homusman/EEEbike/(list of files, drawings)

Other design files:
Hardware/KICAD PCB/esp32_ESC/esc_noninterlocked_integrated/freerouting.dsn
Hardware/KICAD PCB/esp32_ESC/esc_noninterlocked_integrated/temp-freerouting.dsn
