homusman/EEEbike/Hardware/KICAD PCB/esp32_ESC/esc_noninterlocked_integrated/esc_noninterlocked_integrated.kicad_pcb

## KiCad design Hardware/KICAD PCB/esp32_ESC/esc_noninterlocked_integrated/esc_noninterlocked_integrated.kicad_pcb (2023-04-12)

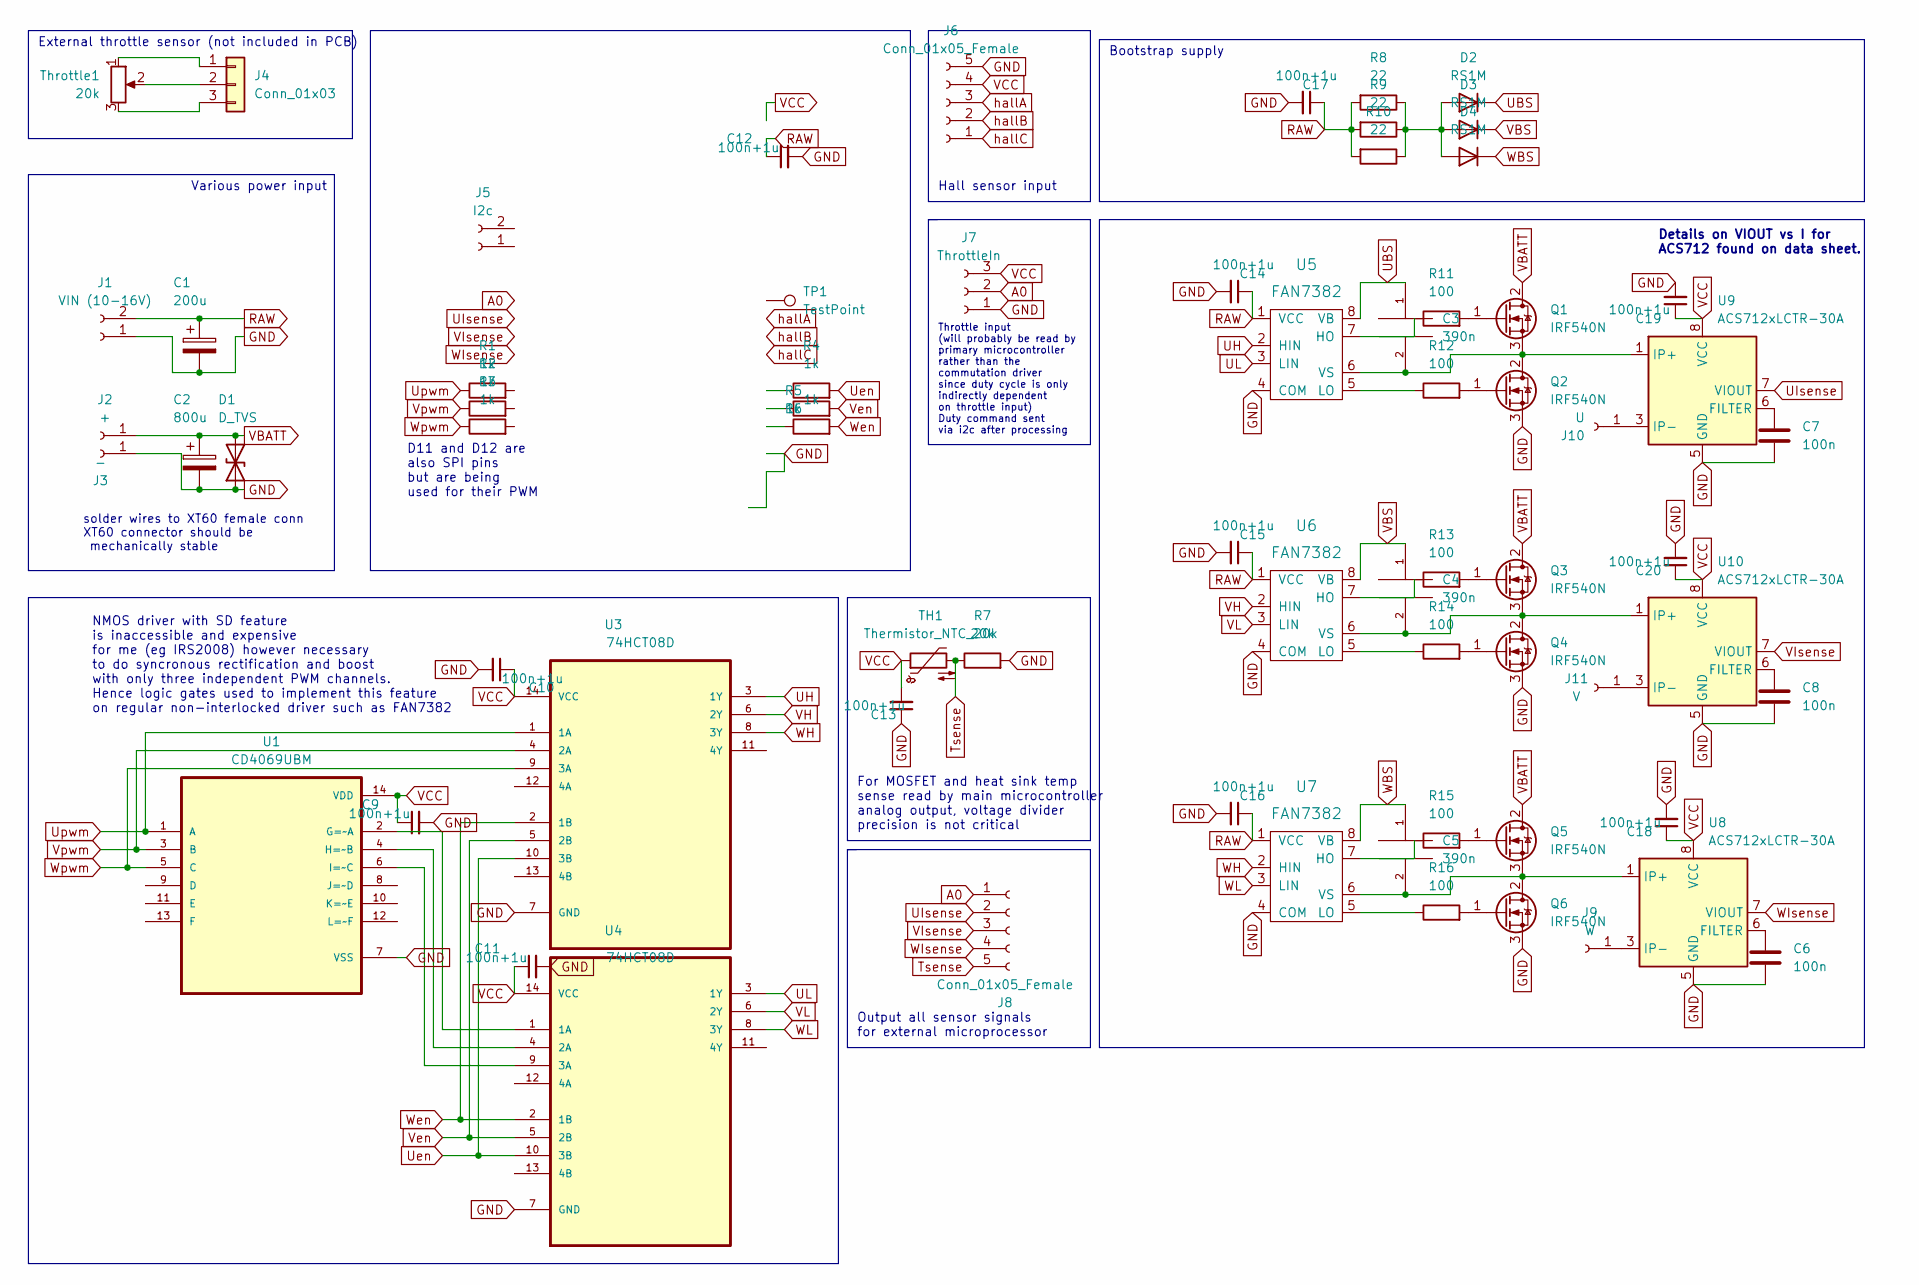
[picture p1: schematic esc_noninterlocked_integrated.kicad_sch]

Parts:
C1: 200u; CP_Radial_D8.0mm_P5.00mm
C2: 800u; CP_Axial_L10.0mm_D4.5mm_P15.00mm_Horizontal
C3, C4, C5: 390n; C_Rect_L7.0mm_W4.5mm_P5.00mm
C6, C7, C8: 100n; C_0603_1608Metric_Pad1.08x0.95mm_HandSolder
C9, C10, C11, C12, C13, C14, C15, C16, C17, C18, C19, C20: 100n+1u; Dual Capacitor SMD 0603 and 0805_HandSolder
D1: D_TVS; D_0805_2012Metric_Pad1.15x1.40mm_HandSolder
D2, D3, D4: RS1M; D_3220_8050Metric_Pad2.65x5.15mm_HandSolder
J1: VIN (10-16V); JST_EH_B2B-EH-A_1x02_P2.50mm_Vertical
J2: +; TestPoint_Loop_D3.80mm_Drill2.5mm
J3: -; TestPoint_Loop_D3.80mm_Drill2.5mm
J4: Conn_01x03; JST_EH_B3B-EH-A_1x03_P2.50mm_Vertical
J5: I2c; JST_EH_B2B-EH-A_1x02_P2.50mm_Vertical
J6, J8: Conn_01x05_Female; JST_EH_B5B-EH-A_1x05_P2.50mm_Vertical
J7: ThrottleIn; JST_EH_B3B-EH-A_1x03_P2.50mm_Vertical
J9: W; TestPoint_Loop_D3.80mm_Drill2.5mm
J10: U; TestPoint_Loop_D3.80mm_Drill2.5mm
J11: V; TestPoint_Loop_D3.80mm_Drill2.5mm
Q1, Q2, Q3, Q4, Q5, Q6: IRF540N; TO-220-3_Horizontal_TabUp_NoHoleClearance
R1, R2, R3, R4, R5, R6: 1k; R_1206_3216Metric_Pad1.30x1.75mm_HandSolder
R7: 20k; R_0805_2012Metric_Pad1.20x1.40mm_HandSolder
R8, R9, R10: 22; R_0805_2012Metric_Pad1.20x1.40mm_HandSolder
R11, R12, R13, R14, R15, R16: 100; R_1206_3216Metric_Pad1.30x1.75mm_HandSolder
TH1: Thermistor_NTC_20k; R_Axial_DIN0204_L3.6mm_D1.6mm_P1.90mm_Vertical
TP1: TestPoint; TestPoint_Loop_D1.80mm_Drill1.0mm_Beaded
Throttle1: 20k
U1: CD4069UBM; SOIC127P600X175-14N
U3, U4: 74HCT08D; SOIC127P600X175-14N; MPN 74HCT08D
U5, U6, U7: FAN7382; DIP762W52P254L1016H469Q8
U8, U9, U10: ACS712xLCTR-30A; SOIC-8_3.9x4.9mm_P1.27mm

Connections:
A0: J7.2, J8.1; also elsewhere on the board
GND: C1.2, C2.2, C6.2, C7.2, C8.2, C9.2, C10.2, C11.2, C12.2, C13.1, C14.2, C15.2, C16.2, C17.2, C18.2, C19.2, C20.2, D1.1 (A1), J1.1, J3.1, J6.5, J7.1, Q2.3 (S), Q4.3 (S), Q6.3 (S), R7.2, U1.7 (VSS), U3.7 (GND), U4.7 (GND), U5.4 (COM), U6.4 (COM), U7.4 (COM), U8.5 (GND), U9.5 (GND), U10.5 (GND); also elsewhere on the board
unnamed: C3.2, Q1.3 (S), Q2.2 (D), U5.6 (VS), U9.1 (IP+), U9.2 (IP+)
unnamed: C4.2, Q3.3 (S), Q4.2 (D), U6.6 (VS), U10.1 (IP+), U10.2 (IP+)
unnamed: C5.2, Q5.3 (S), Q6.2 (D), U7.6 (VS), U8.1 (IP+), U8.2 (IP+)
unnamed: C6.1, U8.6 (FILTER)
unnamed: C7.1, U9.6 (FILTER)
unnamed: C8.1, U10.6 (FILTER)
unnamed: D2.2 (A), D3.2 (A), D4.2 (A), R8.1, R9.1, R10.1
unnamed: J4.1, Throttle1.1
unnamed: J4.2, Throttle1.2
unnamed: J4.3, Throttle1.3
unnamed 12: J5.1; also elsewhere on the board
unnamed 13: J5.2; also elsewhere on the board
unnamed: J9.1, U8.3 (IP-), U8.4 (IP-)
unnamed: J10.1, U9.3 (IP-), U9.4 (IP-)
unnamed: J11.1, U10.3 (IP-), U10.4 (IP-)
unnamed: Q1.1 (G), R11.2
unnamed: Q2.1 (G), R12.2
unnamed: Q3.1 (G), R13.2
unnamed: Q4.1 (G), R14.2
unnamed: Q5.1 (G), R15.2
unnamed: Q6.1 (G), R16.2
unnamed 23: R1.2; also elsewhere on the board
unnamed 24: R2.2; also elsewhere on the board
unnamed 25: R3.2; also elsewhere on the board
unnamed 26: R4.1; also elsewhere on the board
unnamed 27: R5.1; also elsewhere on the board
unnamed 28: R6.1; also elsewhere on the board
unnamed: R11.1, U5.7 (HO)
unnamed: R12.1, U5.5 (LO)
unnamed: R13.1, U6.7 (HO)
unnamed: R14.1, U6.5 (LO)
unnamed: R15.1, U7.7 (HO)
unnamed: R16.1, U7.5 (LO)
unnamed 35: TP1.1; also elsewhere on the board
unnamed: U1.2 (G=~A), U4.1 (1A)
unnamed: U1.4 (H=~B), U4.4 (2A)
unnamed: U1.6 (I=~C), U4.9 (3A)
RAW: C1.1, C12.1, C14.1, C15.1, C16.1, C17.1, J1.2, R8.2, R9.2, R10.2, U5.1 (VCC), U6.1 (VCC), U7.1 (VCC); also elsewhere on the board
Tsense: J8.5, R7.1, TH1.2
UBS: C3.1, D2.1 (K), U5.8 (VB)
UH: U3.3 (1Y), U5.2 (HIN)
UIsense: J8.2, U9.7 (VIOUT); also elsewhere on the board
UL: U4.3 (1Y), U5.3 (LIN)
Uen: R4.2, U3.10 (3B), U4.10 (3B)
Upwm: R1.1, U1.1 (A), U3.1 (1A)
VBATT: C2.1, D1.2 (A2), J2.1, Q1.2 (D), Q3.2 (D), Q5.2 (D)
VBS: C4.1, D3.1 (K), U6.8 (VB)
VCC: C9.1, C10.1, C11.1, C13.2, C18.1, C19.1, C20.1, J6.4, J7.3, TH1.1, U1.14 (VDD), U3.14 (VCC), U4.14 (VCC), U8.8 (VCC), U9.8 (VCC), U10.8 (VCC); also elsewhere on the board
VH: U3.6 (2Y), U6.2 (HIN)
VIsense: J8.3, U10.7 (VIOUT); also elsewhere on the board
VL: U4.6 (2Y), U6.3 (LIN)
Ven: R5.2, U3.5 (2B), U4.5 (2B)
Vpwm: R2.1, U1.3 (B), U3.4 (2A)
WBS: C5.1, D4.1 (K), U7.8 (VB)
WH: U3.8 (3Y), U7.2 (HIN)
WIsense: J8.4, U8.7 (VIOUT); also elsewhere on the board
WL: U4.8 (3Y), U7.3 (LIN)
Wen: R6.2, U3.2 (1B), U4.2 (1B)
Wpwm: R3.1, U1.5 (C), U3.9 (3A)
hallA: J6.3; also elsewhere on the board
hallB: J6.2; also elsewhere on the board
hallC: J6.1; also elsewhere on the board

Notes on the sheet:
Hall sensor input
D11 and D12 are also SPI pins but are being used for their PWM
Throttle input (will probably be read by primary microcontroller rather than the commutation driver since duty cycle is only indirectly dependent on throttle input) Duty command sent via i2c after processing
Output all sensor signals for external microprocessor
solder wires to XT60 female conn XT60 connector should be mechanically stable
For MOSFET and heat sink temp sense read by main microcontroller analog output, voltage divider precision is not critical
Bootstrap supply
External throttle sensor (not included in PCB)
Details on VIOUT vs I for ACS712 found on data sheet.
Various power input
NMOS driver with SD feature is inaccessible and expensive for me (eg IRS2008) however necessary to do syncronous rectification and boost with only three independent PWM channels. Hence logic gates used to implement this feature on regular non-interlocked driver such as FAN7382

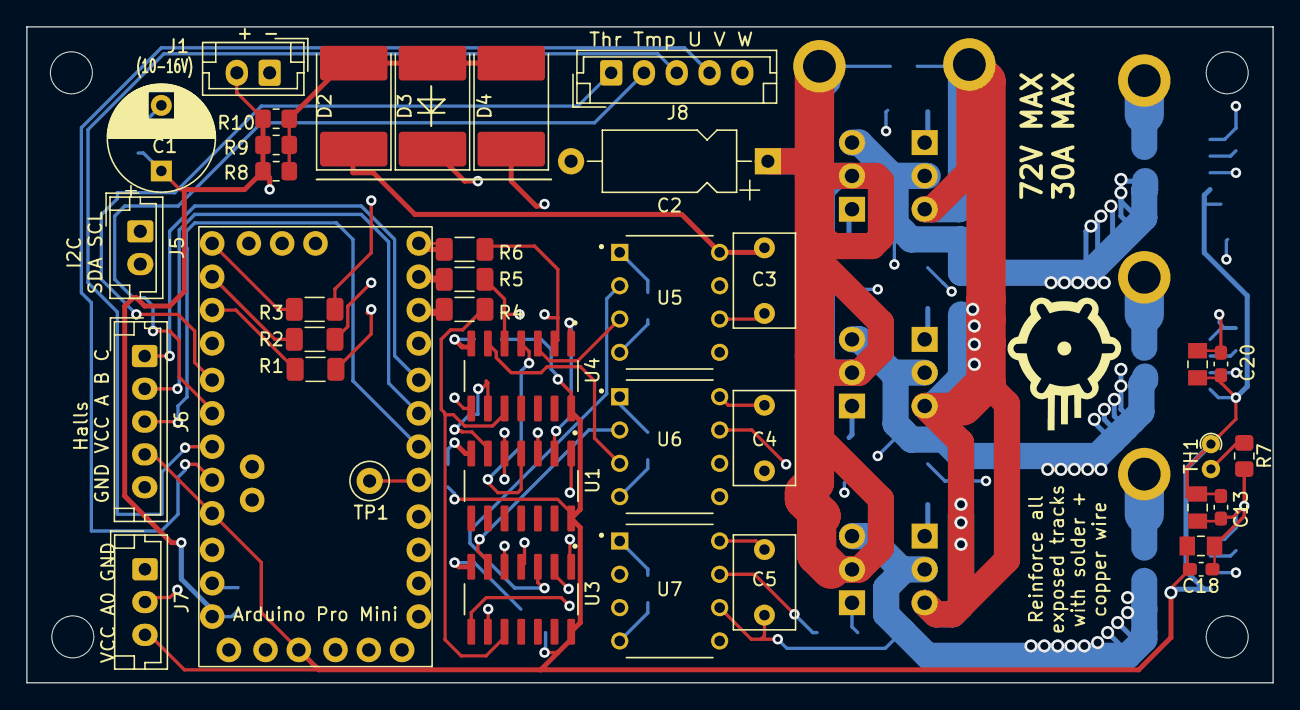
[picture p2: board esc_noninterlocked_integrated.kicad_pcb from above]

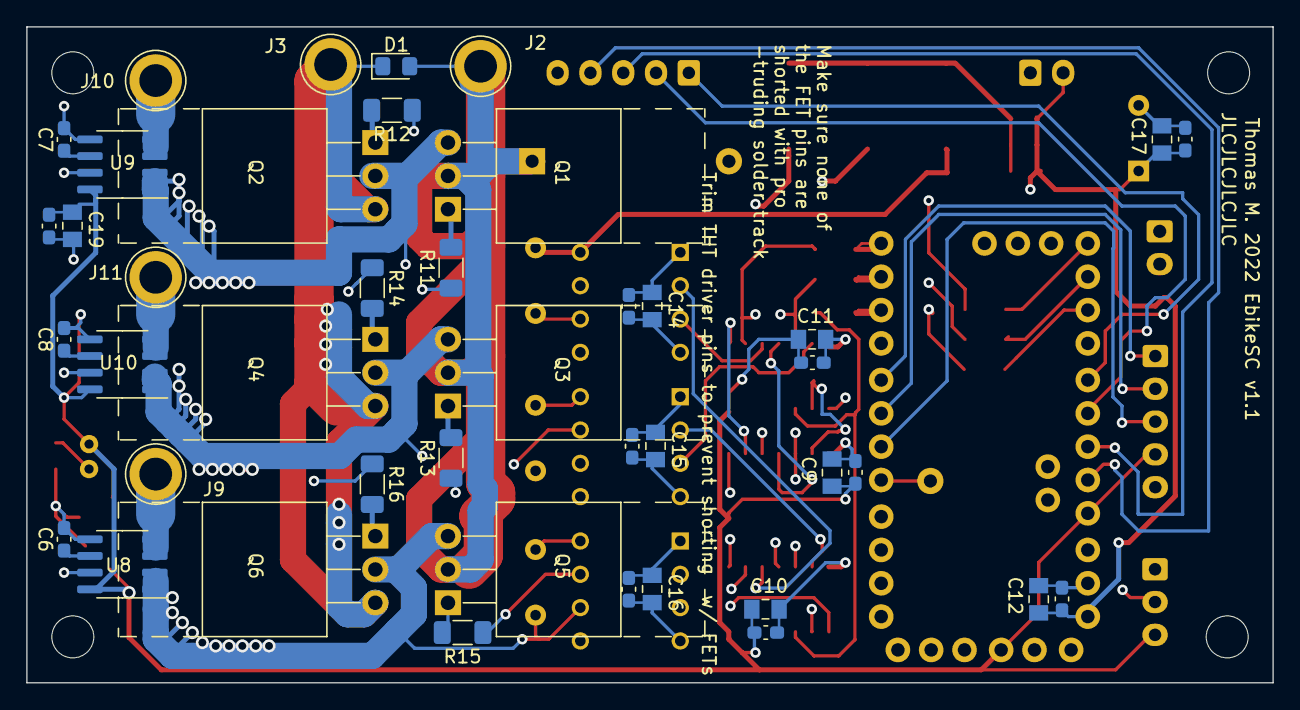
[picture p3: board esc_noninterlocked_integrated.kicad_pcb from below]

Board: 4 copper layers, 95.0 x 50.0 mm, 68 parts (33 on the bottom side), 61 nets.

Other parts of the board:
U2: ARDUINO_PRO_MINI; ARDUINO_PRO_MINI_ALIEXPRESS

Their connections:
A0: U2.18 (A0); also elsewhere on the board
GND: U2.5 (GND), U2.6 (GND), U2.12 (GND_1), U2.31 (GND_2), U2.35 (GND); also elsewhere on the board
unnamed 12: U2.8 (A5); also elsewhere on the board
unnamed 13: U2.7 (A4); also elsewhere on the board
unnamed 23: U2.20 (MISO); also elsewhere on the board
unnamed 24: U2.21 (MOSI); also elsewhere on the board
unnamed 25: U2.22 (D10); also elsewhere on the board
unnamed 26: U2.25 (D7); also elsewhere on the board
unnamed 27: U2.24 (D8); also elsewhere on the board
unnamed 28: U2.23 (D9); also elsewhere on the board
unnamed 35: U2.30 (D2); also elsewhere on the board
RAW: U2.11 (RAW); also elsewhere on the board
UIsense: U2.17 (A1); also elsewhere on the board
VCC: U2.4 (VCC), U2.14 (VCC_1); also elsewhere on the board
VIsense: U2.16 (A2); also elsewhere on the board
WIsense: U2.15 (A3); also elsewhere on the board
hallA: U2.29 (D3); also elsewhere on the board
hallB: U2.28 (D4); also elsewhere on the board
hallC: U2.27 (D5); also elsewhere on the board
