homusman/EEEbike/Hardware/KICAD PCB/esp32_ESC/esc_noninterlocked_integrated/esp32_esc.kicad_pcb

## KiCad design Hardware/KICAD PCB/esp32_ESC/esc_noninterlocked_integrated/esp32_esc.kicad_pcb (2023-04-12)

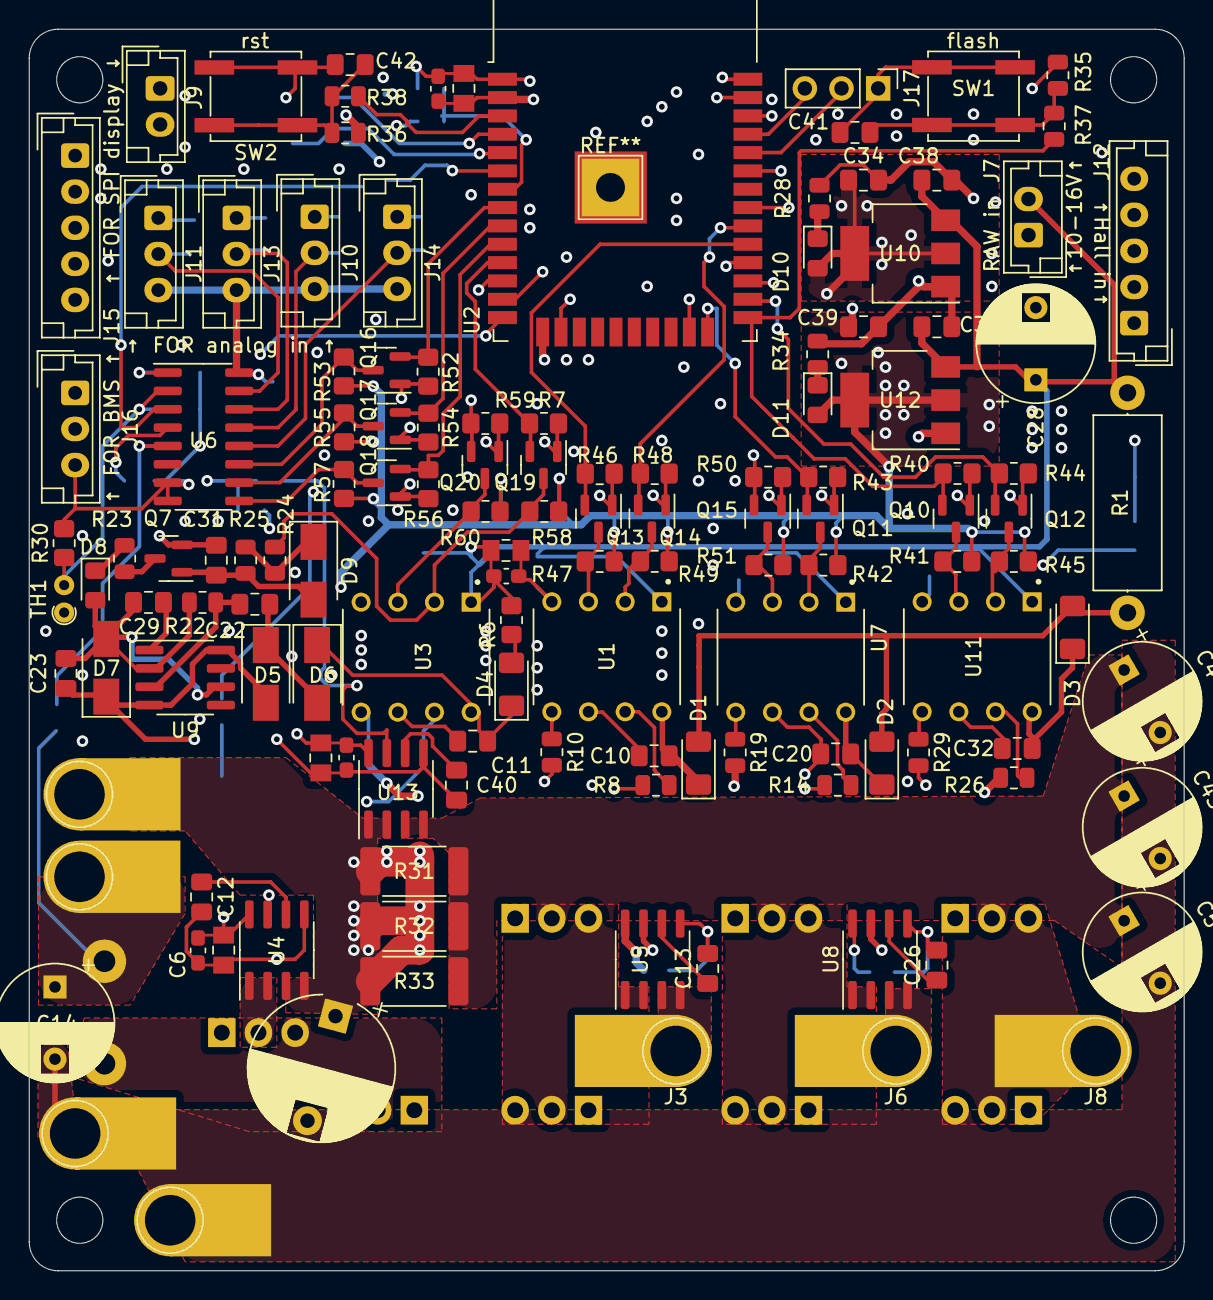
[picture p4: board esp32_esc.kicad_pcb from above]

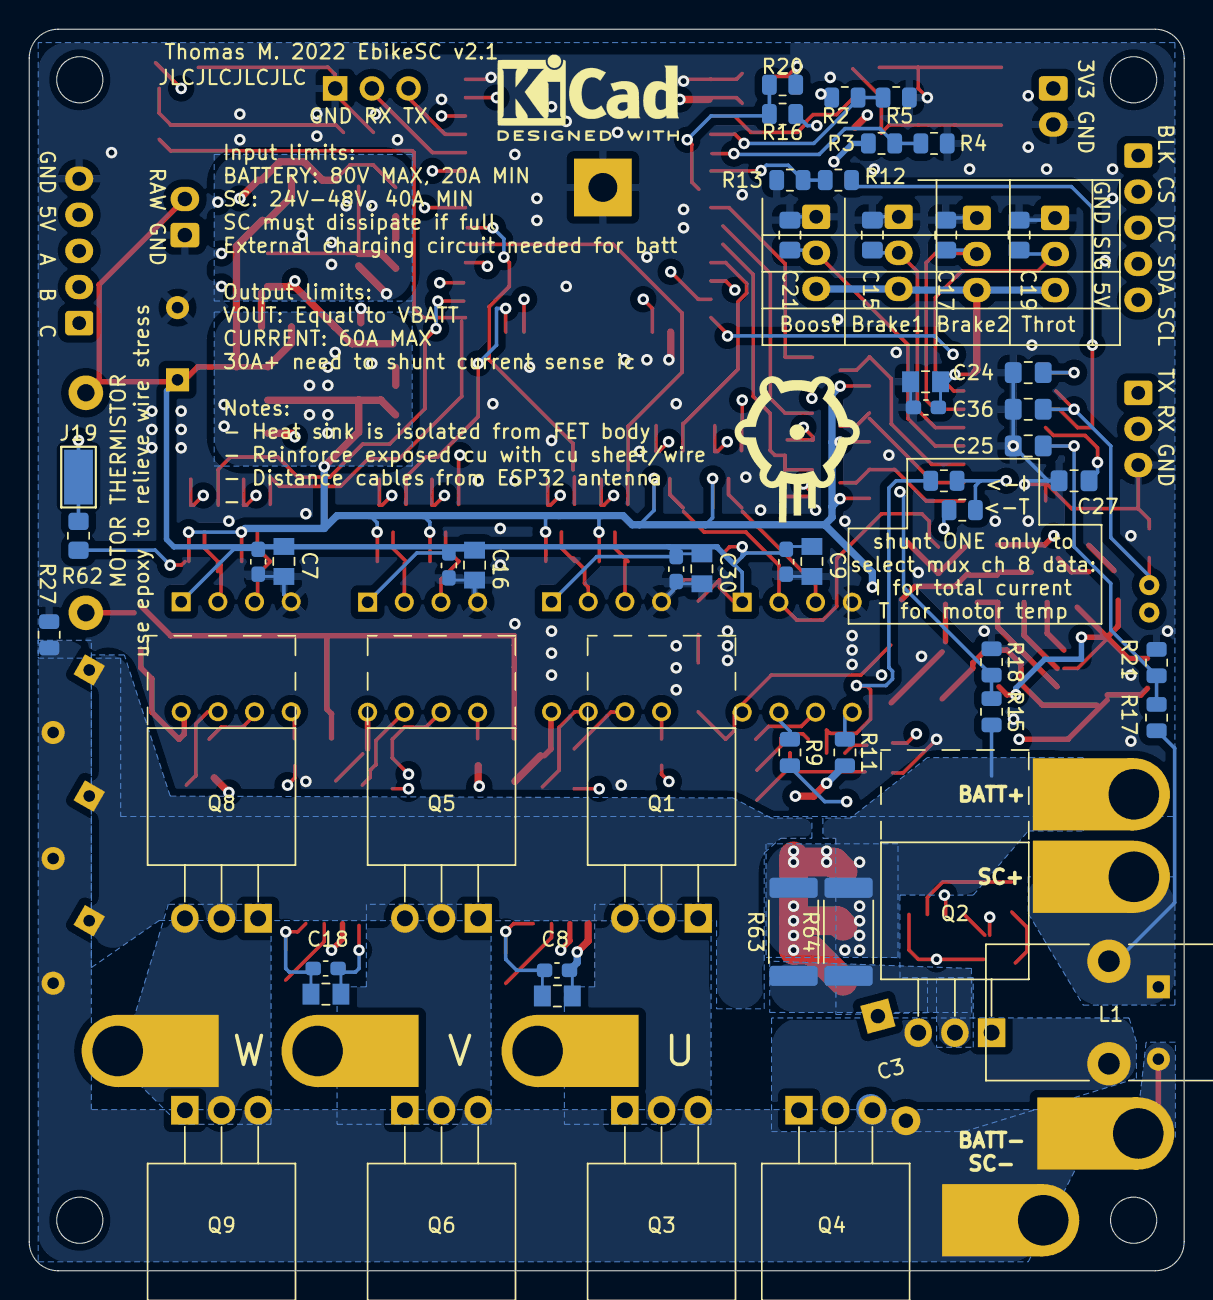
[picture p5: board esp32_esc.kicad_pcb from below]

Board: 4 copper layers, 80.0 x 86.0 mm, 173 parts (45 on the bottom side), 105 nets.

Parts:
C1, C2, C6, C7, C8, C9, C16, C18, C30, C35, C37: 100n; Dual Capacitor SMD 0603 and 0805_HandSolder
C3: 300u; CP_Radial_D10.0mm_P7.50mm
C4, C5, C14, C28, C43: 300u; CP_Radial_D8.0mm_P5.00mm
C10, C11, C20, C32: 390n; C_0805_2012Metric_Pad1.18x1.45mm_HandSolder
C12, C13, C15, C17, C19, C21, C24, C25, C26, C27, C31, C36, C40, C41, C42: 100n; C_0805_2012Metric_Pad1.18x1.45mm_HandSolder
C22: 20n; C_0805_2012Metric_Pad1.18x1.45mm_HandSolder
C23: 1u; C_0805_2012Metric_Pad1.18x1.45mm_HandSolder
C29: 1nf; C_0805_2012Metric_Pad1.18x1.45mm_HandSolder
C33, C34, C38, C39: 22u; C_0805_2012Metric_Pad1.18x1.45mm_HandSolder
D1, D2, D3, D4: RS1M; D_1206_3216Metric_Pad1.42x1.75mm_HandSolder
D5, D6, D9: SS14; D_SMA
D7: Zener12; D_SMA
D8, D10, D11: GREENLED; D_0805_2012Metric_Pad1.15x1.40mm_HandSolder
J1: BatteryIn+; TestPoint_Plated_Hole_D3.5mm
J2: BatteryIn-; TestPoint_Plated_Hole_D3.5mm
J3: U; TestPoint_Plated_Hole_D3.5mm
J4: SCIn+ (24-48V); TestPoint_Plated_Hole_D3.5mm
J5: SCIn-; TestPoint_Plated_Hole_D3.5mm
J6: V; TestPoint_Plated_Hole_D3.5mm
J7: VIN (10-16V); JST_EH_B2B-EH-A_1x02_P2.50mm_Vertical
J8: W; TestPoint_Plated_Hole_D3.5mm
J9: dispPwr; JST_EH_B2B-EH-A_1x02_P2.50mm_Vertical
J10: brake1; JST_EH_B3B-EH-A_1x03_P2.50mm_Vertical
J11: throttle; JST_EH_B3B-EH-A_1x03_P2.50mm_Vertical
J12: hall; JST_EH_B5B-EH-A_1x05_P2.50mm_Vertical
J13: brake2; JST_EH_B3B-EH-A_1x03_P2.50mm_Vertical
J14: boost; JST_EH_B3B-EH-A_1x03_P2.50mm_Vertical
J15: dispSPI; JST_EH_B5B-EH-A_1x05_P2.50mm_Vertical
J16: BMS; JST_EH_B3B-EH-A_1x03_P2.50mm_Vertical
J17: UART; PinHeader_1x03_P2.54mm_Vertical
J19: Conn_01x01_Female; TestPoint_Keystone_5019_Minature
L1: 4u; L_Toroid_Vertical_L16.8mm_W9.2mm_P7.10mm_Vishay_TJ3_BigPads
Q1, Q2, Q3, Q4, Q5, Q6, Q8, Q9: IRF3710; TO-220-3_Horizontal_TabUp_NoHoleClearance
Q7, Q10, Q11, Q12, Q13, Q14, Q15, Q16, Q17, Q18, Q19, Q20: 2N7002; SOT-23
R1: 10; R_Axial_DIN0414_L11.9mm_D4.5mm_P15.24mm_Horizontal
R2, R3, R12, R16: 1k; R_0805_2012Metric
R4, R5, R13, R20: 2k; R_0805_2012Metric
R6: 47; R_0805_2012Metric_Pad1.20x1.40mm_HandSolder
R7, R40, R41, R42, R43, R44, R45, R46, R47, R48, R49, R50, R51, R52, R53, R54, R55, R56, R57, R58, R59, R60: 10k; R_0805_2012Metric_Pad1.20x1.40mm_HandSolder
R8, R10, R14, R19, R26, R29: 100; R_0805_2012Metric
R9, R11: 40; R_0805_2012Metric
R15: 200k; R_0805_2012Metric
R17: 100k; R_0805_2012Metric
R18, R21: 10k; R_0805_2012Metric
R22: 47k; R_0805_2012Metric
R23: 3400; R_0805_2012Metric
R24, R37, R38: 470; R_0805_2012Metric
R25, R35, R36: 4.7k; R_0805_2012Metric
R27, R39, R61: 10m; R_0805_2012Metric
R28: 260; R_0805_2012Metric
R30, R62: 20k; R_0805_2012Metric_Pad1.20x1.40mm_HandSolder
R31, R32, R33, R63, R64: 1.2m; R_2512_6332Metric_Pad1.40x3.35mm_HandSolder
R34: 600; R_0805_2012Metric
SW1, SW2: SW_MEC_5G; SW_SPST_EVPBF
TH1: Thermistor_NTC_20k; R_Axial_DIN0204_L3.6mm_D1.6mm_P1.90mm_Vertical
U1, U3, U7, U11: FAN7382; DIP762W52P254L1016H469Q8
U2: ESP32-WROOM-32
U4, U5, U8, U13: ACS712xLCTR-30A; SOIC-8_3.9x4.9mm_P1.27mm
U6: CD4051B; SOIC-16_3.9x9.9mm_P1.27mm
U9: LM555xM; SOIC-8_3.9x4.9mm_P1.27mm
U10: AMS1117-3.3; SOT-223-3_TabPin2
U12: AMS1117-5.0; SOT-223-3_TabPin2

Connections:
+3V3: C2.2, C34.1, D10.2 (A), J9.1, Q10.1 (G), Q11.1 (G), Q12.1 (G), Q13.1 (G), Q14.1 (G), Q15.1 (G), Q16.1 (G), Q17.1 (G), Q18.1 (G), Q19.1 (G), Q20.1 (G), R7.1, R35.2, R36.2, R40.1, R42.1, R44.1, R46.1, R48.1, R50.1, R52.1, R54.1, R56.1, R59.1, U2.2 (VDD), U10.2 (VO)
+5V: C6.1, C8.1, C18.1, C35.2, C37.2, C39.1, D11.2 (A), J10.3, J11.3, J12.4, J13.3, J14.3, R41.1, R43.1, R45.1, R47.1, R49.1, R51.1, R53.1, R55.1, R57.1, R58.1, R60.1, R62.2, TH1.1, U4.8 (VCC), U5.8 (VCC), U6.16 (VDD), U8.8 (VCC), U12.2 (VO), U13.8 (VCC)
/3V3to5V1/LIN: Q11.2 (S), R42.2, U2.24 (IO2)
/3V3to5V2/LIN: Q12.2 (S), R44.2, U2.26 (IO4)
/3V3to5V3/LIN: Q13.2 (S), R46.2, U2.29 (IO5)
/3V3to5V4/LIN: Q14.2 (S), R48.2, U2.30 (IO18)
/3V3to5V5/LIN: Q15.2 (S), R50.2, U2.37 (IO23)
/3V3to5V6/HIN: Q16.3 (D), R53.2, U6.11 (A)
/3V3to5V6/LIN: Q16.2 (S), R52.2, U2.8 (IO32)
/3V3to5V7/HIN: Q17.3 (D), R55.2, U6.10 (B)
/3V3to5V7/LIN: Q17.2 (S), R54.2, U2.9 (IO33)
/3V3to5V8/HIN: Q18.3 (D), R57.2, U6.9 (C)
/3V3to5V8/LIN: Q18.2 (S), R56.2, U2.10 (IO25)
/3V3to5V9/LIN: Q20.2 (S), R59.2, U2.12 (IO27)
/3V3to5V10/LIN: Q19.2 (S), R7.2, U2.11 (IO26)
CS: J15.2, U2.23 (IO15)
DC: J15.3, U2.14 (IO12)
EN: R38.1, U2.3 (EN)
GND: C1.2, C2.1, C6.2, C7.2, C8.2, C9.2, C12.2, C13.2, C15.1, C16.2, C17.1, C18.2, C19.1, C21.1, C24.1, C25.1, C26.2, C27.1, C28.2, C30.2, C33.2, C34.2, C35.1, C36.1, C37.1, C38.2, C39.2, C40.2, C41.1, C42.1, J7.1, J9.2, J10.1, J11.1, J12.5, J13.1, J14.1, J16.3, J17.1, R4.1, R5.1, R13.1, R18.1, R20.1, R21.1, R27.2, R28.1, R30.2, R34.1, SW1.2 (B), SW2.2 (B), U1.4 (COM), U2.1 (GND), U2.15 (GND), U2.38 (GND), U2.39 (GND), U3.4 (COM), U4.5 (GND), U5.5 (GND), U6.7 (VEE), U6.8 (VSS), U7.4 (COM), U8.5 (GND), U10.1 (GND), U11.4 (COM), U12.1 (GND), U13.5 (GND)
GNDPWR: C3.2, C4.2, C5.2, C14.2, C31.2, C43.2, J2.1, J5.1, Q3.3 (S), Q4.3 (S), Q6.3 (S), Q7.2 (S), Q9.3 (S), R27.1
IO0: Q10.2 (S), R37.1, R40.2, U2.25 (IO0)
I_Bsense: R16.2, U4.7 (VIOUT)
I_Usense: R3.1, U5.7 (VIOUT)
I_Vsense: R2.1, U8.7 (VIOUT)
I_totsense: R39.2, U13.7 (VIOUT)
unnamed: C10.2, Q1.3 (S), Q3.2 (D), U1.6 (VS), U5.1 (IP+), U5.2 (IP+)
unnamed: C12.1, U4.6 (FILTER)
unnamed: C13.1, U5.6 (FILTER)
unnamed: C20.2, Q5.3 (S), Q6.2 (D), U7.6 (VS), U8.1 (IP+), U8.2 (IP+)
unnamed: C22.1, D5.1 (K), D6.2 (A)
unnamed: C22.2, R22.1, U9.3 (Q)
unnamed: C23.2, C29.1, D7.2 (A), D8.2 (A), R22.2, U9.2 (TR), U9.6 (THR)
unnamed: C24.2, R15.1, R18.2, U6.1 (X4)
unnamed: C25.2, R17.1, R21.2, U6.5 (X5)
unnamed: C26.1, U8.6 (FILTER)
unnamed: C27.2, R39.1, R61.1, U6.4 (X7)
unnamed: C29.2, U9.1 (GND)
unnamed: C31.1, D9.2 (A), Q7.1 (G), R25.2
unnamed: C32.2, J8.1, Q8.3 (S), Q9.2 (D), U11.6 (VS)
unnamed: C40.1, U13.6 (FILTER)
unnamed: C41.2, R35.1, R37.2, SW1.1 (A)
unnamed: C42.2, R36.1, R38.2, SW2.1 (A)
unnamed: D1.2 (A), D2.2 (A), D3.2 (A), R1.1
unnamed: D4.2 (A), R6.1
unnamed: D8.1 (K), R23.1
unnamed: D9.1 (K), R24.2, R25.1
unnamed: D10.1 (K), R28.2
unnamed: D11.1 (K), R34.2
unnamed: J3.1, U5.3 (IP-), U5.4 (IP-)
unnamed: J6.1, U8.3 (IP-), U8.4 (IP-)
unnamed: J17.2, U2.34 (RXD0/IO3)
unnamed: J17.3, U2.35 (TXD0/IO1)
unnamed: Q1.1 (G), R8.2
unnamed: Q2.1 (G), R9.2
unnamed: Q2.2 (D), R63.1, R64.1, U4.1 (IP+), U4.2 (IP+)
unnamed: Q3.1 (G), R10.2
unnamed: Q4.1 (G), R11.2
unnamed: Q5.1 (G), R14.2
unnamed: Q6.1 (G), R19.2
unnamed: Q7.3 (D), R23.2
unnamed: Q8.1 (G), R26.2
unnamed: Q9.1 (G), R29.2
unnamed: R2.2, R5.2, U2.4 (SENSOR_VP)
unnamed: R3.2, R4.2, U2.5 (SENSOR_VN)
unnamed: R8.1, U1.7 (HO)
unnamed: R9.1, U3.7 (HO)
unnamed: R10.1, U1.5 (LO)
unnamed: R11.1, U3.5 (LO)
unnamed: R12.1, R13.2, U2.6 (IO34)
unnamed: R12.2, U6.3 (X)
unnamed: R14.1, U7.7 (HO)
unnamed: R16.1, R20.2, U2.7 (IO35)
unnamed: R19.1, U7.5 (LO)
unnamed: R26.1, U11.7 (HO)
unnamed: R29.1, U11.5 (LO)
RAW: C1.1, C7.1, C9.1, C16.1, C28.1, C30.1, C33.1, C38.1, J7.2, R1.2, R6.2, U1.1 (VCC), U3.1 (VCC), U7.1 (VCC), U10.3 (VI), U11.1 (VCC), U12.3 (VI)
RX_forbms: J16.2, U2.27 (IO16)
SCL: J15.5, U2.13 (IO14)
SDA: J15.4, U2.16 (IO13)
SR: Q19.3 (D), R24.1, R58.2, U3.2 (HIN)
SW: Q20.3 (D), R60.2, U3.3 (LIN)
TX_forbms: J16.1, U2.28 (IO17)
Tmotor: J19.1, R61.2, R62.1
Tsink: C36.2, R30.1, TH1.2, U6.2 (X6)
UBS: C10.1, D1.1 (K), U1.8 (VB)
UH: Q14.3 (D), R49.2, U1.2 (HIN)
UL: Q13.3 (D), R47.2, U1.3 (LIN)
VBS: C20.1, D2.1 (K), U7.8 (VB)
VBUS: C3.1, J1.1, R15.2, R31.1, R32.1, R33.1, R63.2, R64.2, U4.3 (IP-), U4.4 (IP-), U13.1 (IP+), U13.2 (IP+)
VH: Q11.3 (D), R43.2, U7.2 (HIN)
VL: Q15.3 (D), R51.2, U7.3 (LIN)
VMOTOR: C4.1, C5.1, C43.1, Q1.2 (D), Q5.2 (D), Q8.2 (D), R31.2, R32.2, R33.2, U13.3 (IP-), U13.4 (IP-)
VSC: C14.1, J4.1, L1.1, R17.2
Vs: C11.2, C23.1, D5.2 (A), D7.1 (K), L1.2, Q2.3 (S), Q4.2 (D), U3.6 (VS), U9.4 (R), U9.8 (VCC)
WBS: C32.1, D3.1 (K), U11.8 (VB)
WH: Q12.3 (D), R45.2, U11.2 (HIN)
WL: Q10.3 (D), R41.2, U11.3 (LIN)
boost: C21.2, J14.2, U6.12 (X3)
brake1: C15.2, J10.2, U6.13 (X0)
brake2: C17.2, J13.2, U6.14 (X1)
cp: C11.1, D4.1 (K), D6.1 (K), U3.8 (VB)
hallA: J12.3, U2.31 (IO19)
hallB: J12.2, U2.33 (IO21)
hallC: J12.1, U2.36 (IO22)
throttle: C19.2, J11.2, U6.15 (X2)
